Mickael235/pic16-biometric-access-control/hardware/mechanical/solidworks/Biometrique_Boitier.SLDASM

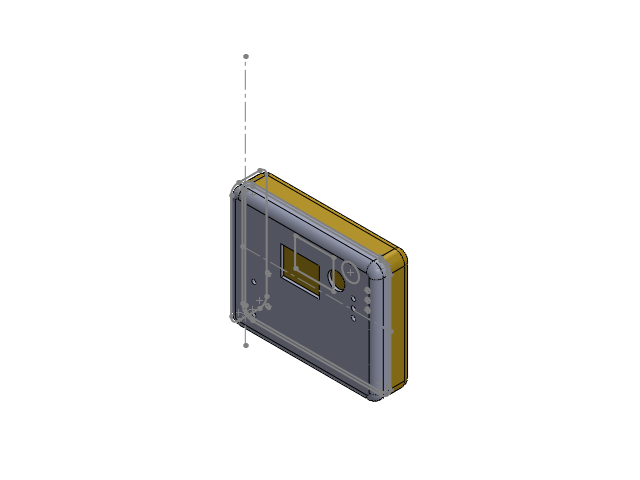
[picture p44: CAD file, 2026-10-03]
hardware/mechanical/solidworks/Biometrique_Boitier.SLDASM
Pièce2^Biometrique_Boitier
Pièce4^Biometrique_Boitier
