Mickael235/pic16-biometric-access-control/hardware/electronics/kicad/Projet mecatronique.kicad_pcb

## KiCad design hardware/electronics/kicad/Projet mecatronique.kicad_pcb (2026-10-03)

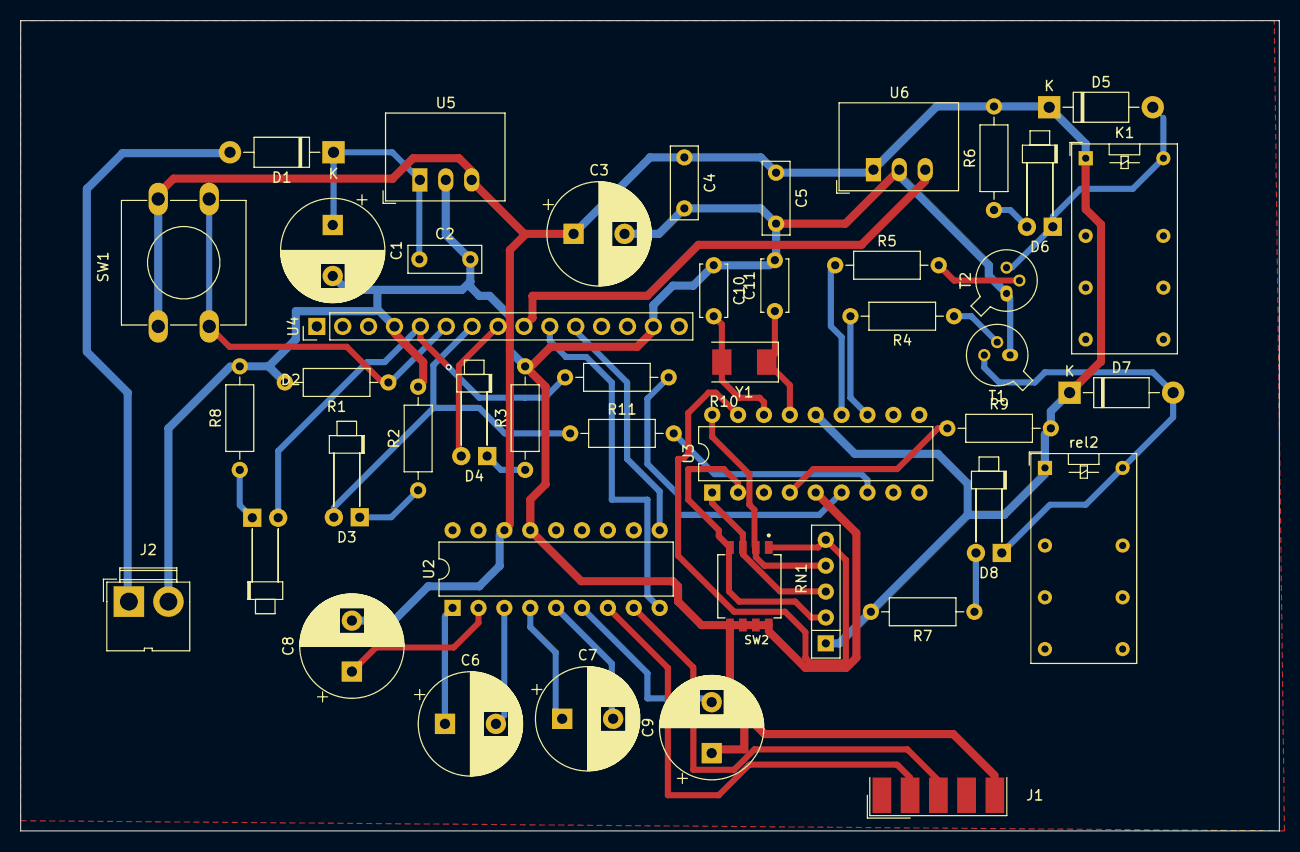
[picture p45: board Projet mecatronique.kicad_pcb from above]

Board: 2 copper layers, 123.5 x 79.5 mm, 45 parts (0 on the bottom side), 38 nets.

Parts:
C1: 100µF; CP_Radial_D10.0mm_P5.00mm
C2, C4, C5: 100nF; C_Rect_L7.0mm_W2.5mm_P5.00mm
C3: 470µF; CP_Radial_D10.0mm_P5.00mm
C6, C7, C8, C9: 10µF; CP_Radial_D10.0mm_P5.00mm
C10, C11: 15pF; C_Disc_D5.0mm_W2.5mm_P5.00mm
D1, D5, D7: 1N4007; D_DO-41_SOD81_P10.16mm_Horizontal
D2, D3, D4, D6, D8: LED; LED_D1.8mm_W1.8mm_H2.4mm_Horizontal_O6.35mm_Z1.6mm
J1: DE9_Plug; DSUB-9_Female_EdgeMount_P2.77mm
J2: Conn_01x02_Pin; JWT_A3963_1x02_P3.96mm_Vertical
K1: G5V-2_Split; Relay_DPDT_Omron_G5V-2
R1, R2, R3, R8: 470; R_Axial_DIN0207_L6.3mm_D2.5mm_P10.16mm_Horizontal
R4, R5, R6, R7: 4.7k; R_Axial_DIN0207_L6.3mm_D2.5mm_P10.16mm_Horizontal
R9: 1k; R_Axial_DIN0207_L6.3mm_D2.5mm_P10.16mm_Horizontal
R10, R11: 220; R_Axial_DIN0207_L6.3mm_D2.5mm_P10.16mm_Horizontal
RN1: R_Network04; R_Array_SIP5
SW1: SW_Push; SW_PUSH-12mm
SW2: SW_DIP_x04
T1, T2: BC108; TO-18-3
U2: MAX232; DIP-18_W7.62mm
U3: PIC16F88-IP; DIP-18_W7.62mm
U4: PinHeader_1x15_P2.54mm_Vertical
U5: R-78E5.0-0.5; Converter_DCDC_RECOM_R-78E-0.5_THT
U6: R-783.3-0.5; Converter_DCDC_RECOM_R-78E-0.5_THT
Y1: Crystal; Crystal_SMD_0603-2Pin_6.0x3.5mm
rel2: G5V-2_Split; Relay_DPDT_Omron_G5V-2

Connections:
/3.3V: U4.9 (VDD), U6.3 (OUT)
/5V: C3.1, C4.1, C5.1, C8.2, D5.1 (K), D7.1 (K), K1.1, R6.2, R7.2, R9.2, RN1.1 (common), SW1.1, U2.16 (VCC), U3.14 (VDD), U5.3 (OUT), U6.1 (IN), rel2.1
/RA1: RN1.4 (R3), SW2.2, U3.18 (AN1/RA1)
/RA2: RN1.3 (R2), SW2.3, U3.1 (Vref-/CVref/AN2/RA2)
/RA3: RN1.2 (R1), SW2.4, U3.2 (C1OUT/Vref+/AN3/RA3)
/RB0: R10.1, U3.6 (RB0/INT/CCP1)
/RB1: R11.2, U3.7 (RB1/SDI/SDA)
/Rx: U2.9 (R2OUT), U4.10 (Rx)
/Tx: U2.10 (T2IN), U4.11 (Tx)
GND: C1.2, C2.2, C3.2, C4.2, C5.2, C9.1, C10.1, C11.2, J1.5, J2.2, R1.2, R2.2, R3.2, R8.2, RN1.5 (R4), SW2.1, SW2.1-1, SW2.2-1, SW2.3-1, SW2.4-1, T1.1 (E), T2.1 (E), U2.15 (GND), U3.5 (VSS), U3.17 (AN0/RA0), U4.4 (Vss), U4.14 (Vss), U5.2 (GND), U6.2 (GND)
unnamed: C1.1, C2.1, D1.1 (K), U5.1 (IN)
unnamed: D2.2 (A), R10.2, U4.5 (GPIO0)
unnamed: D2.1 (K), R8.1
unnamed: D3.2 (A), R11.1, U4.7 (GPIO2)
unnamed: D3.1 (K), R2.1
unnamed: D4.2 (A), U4.8 (GPIO3)
unnamed: D4.1 (K), R3.1
unnamed: D5.2 (A), D6.1 (K), K1.16, T2.3 (C)
unnamed: D6.2 (A), R6.1
unnamed: D7.2 (A), D8.1 (K), T1.3 (C), rel2.16
unnamed: D8.2 (A), R7.1
unnamed: R4.1, T1.2 (B)
unnamed: R5.2, T2.2 (B)
unnamed: C6.1, U2.1 (C1+)
unnamed: C6.2, U2.3 (C1-)
unnamed: C7.1, U2.4 (C2+)
unnamed: C7.2, U2.5 (C2-)
unnamed: J1.3, U2.8 (R2IN)
unnamed: J1.2, U2.7 (T2OUT)
unnamed: C8.1, U2.2 (VS+)
unnamed: C9.2, U2.6 (VS-)
unnamed: C10.2, U3.16 (CLKIN/OSC1/RA7), Y1.2
unnamed: C11.1, U3.15 (CLKOUT/OSC2/RA6), Y1.1
unnamed: R4.2, U3.12 (RB6/AN5/PGC/T1CKI)
unnamed: R5.1, U3.13 (RB7/AN6/PGD/T1OSI)
unnamed: R9.1, U3.4 (~MCLR/Vpp/RA5)
unnamed: R1.1, SW1.2, U4.6 (GPIO1)
VDD: D1.2 (A), J2.1
